STB3/esphome-hotcirc/packages/bg_disinfection_magenta.png

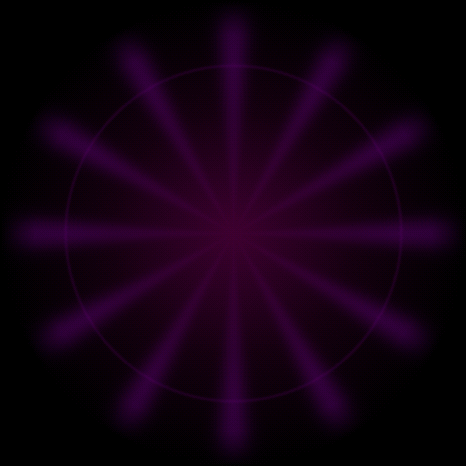
packages/bg_disinfection_magenta.png
