STB3/esphome-hotcirc/packages/bg_idle_blue.png

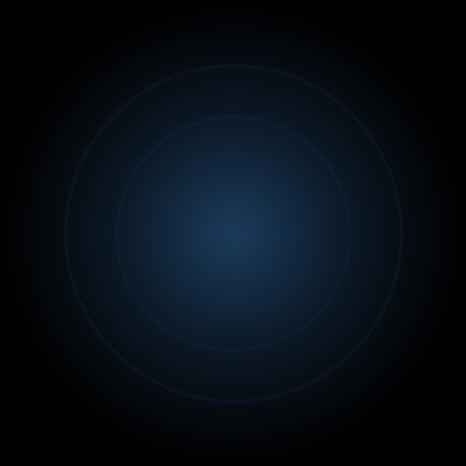
packages/bg_idle_blue.png
