STB3/esphome-hotcirc/mechanics/ring_cover.STL

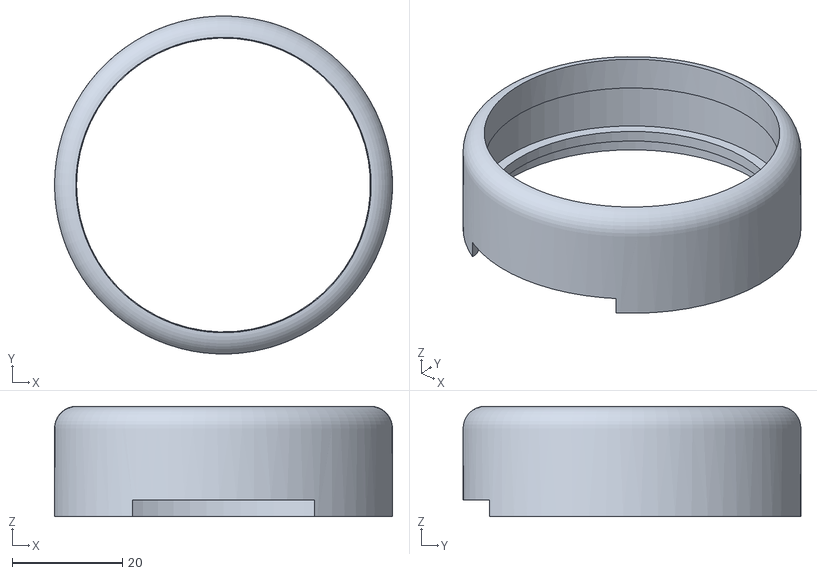
[picture p23: CAD file, 2026-10-16]
mechanics/ring_cover.STL
61.2 x 61.2 x 20.0
