STB3/esphome-hotcirc/mechanics/base.STL

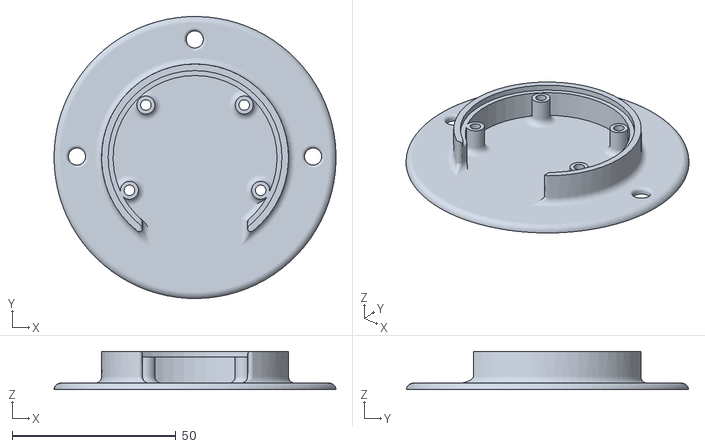
[picture p24: CAD file, 2026-10-16]
mechanics/base.STL
86.0 x 86.0 x 11.7
