STB3/esphome-hotcirc/pictures/hotcirc_red/Schematics_hotcirc_red.pdf

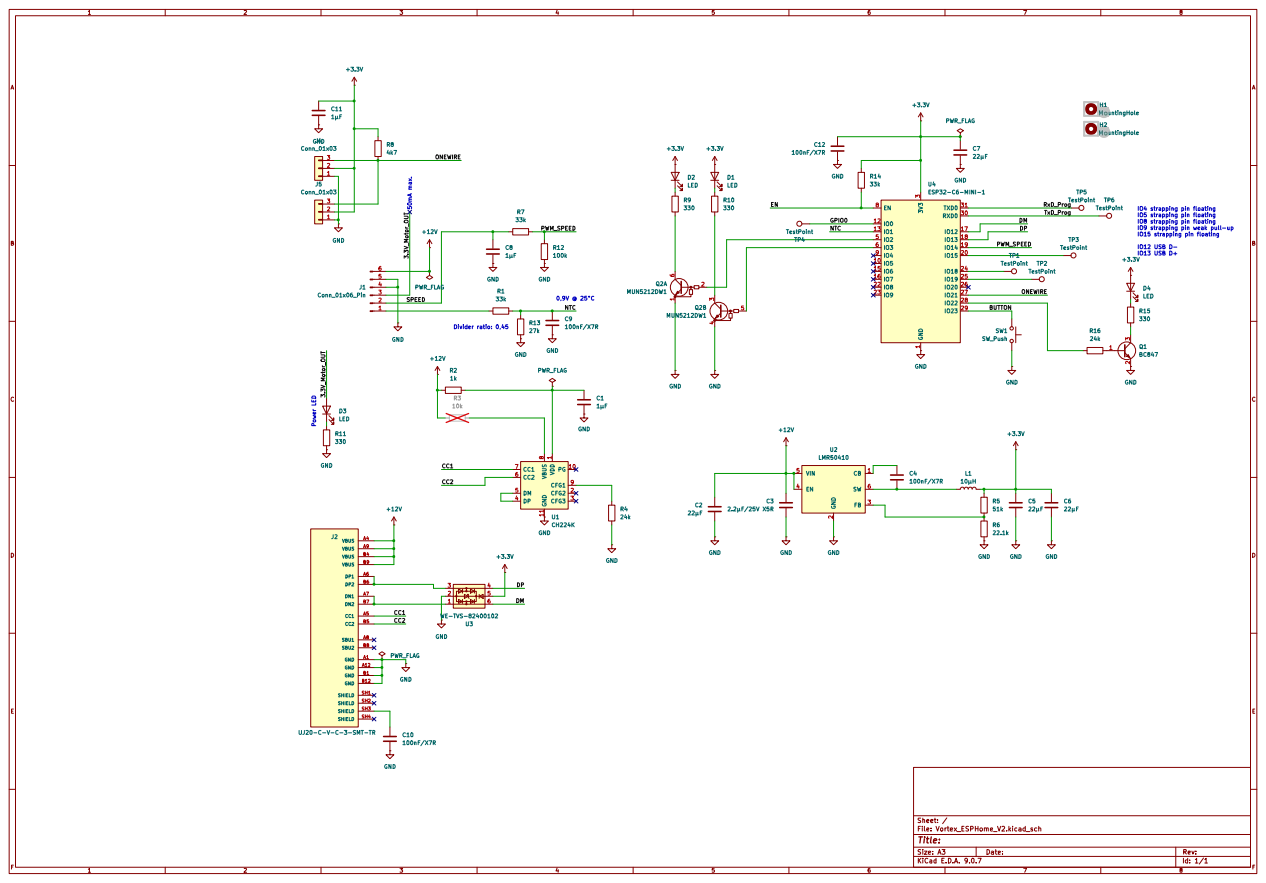
[picture p25: page 1]
