STB3/esphome-hotcirc/(commit log)

2026-02-13 Add pictures of round PCB Changed esphome-hotcirc_uedx4646.yaml to use 2 OneWire busses
2026-02-13 Add picture of schematics
2026-04-10 Fix HTML heatmap file to work with ESPHome 2026.7.0. Free ressources by not exposing internal sensors
    [esphome-hotcirc_m5stickc-plus2.yaml, esphome-hotcirc_red.yaml, esphome-hotcirc_uedx4646.yaml]
2026-04-17 feat: add thermal stagnation flush for summer heat-soak condition
    In summer, when the boiler only heats DHW, the return pipe can absorb
    heat conductively from the boiler. This causes the outlet/return delta
    to shrink or go negative, preventing the normal pump start condition
    from ever being met.
    New check_thermal_stagnation_() runs a short timed flush when:
    - (outlet - return) < thermal_stagnation_delta (default 2.0°C)
    - condition persists for 10 seconds (debounce against sensor noise)
    - return temperature >= thermal_stagnation_min_return (default 40°C)
    to exclude normal overnight cool-down convergence
    - pump is not already running
    - 30-minute cooldown since last flush has elapsed
    Chan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
    [esphome-hotcirc_m5stickc-plus2.yaml, esphome-hotcirc_red.yaml, esphome-hotcirc_uedx4646.yaml, esphome_hotcirc.cpp, esphome_hotcirc.h]
2026-05-07 Add Bill of Materials Change thermal stagnation times
2026-05-07 Add Schematics_hotcirc_red.pdf
2026-05-09 Add factory reset button and safe mode button.
2026-05-09 Add factory reset and safe modde buttons.
    [esphome-hotcirc_m5stickc-plus2.yaml, esphome-hotcirc_uedx4646.yaml]
2026-06-18 fix: use POST instead of GET for smart plug switch control
    ESPHome web_server v3 requires POST requests to actuate switches.
    The previous GET requests to /switch/relay/turn_on|turn_off were
    silently ignored, preventing the pump relay from switching.
    [esphome-hotcirc_m5stickc-plus2.yaml, esphome-hotcirc_uedx4646.yaml]
2026-06-19 Add pictures for pump animation Divide yaml files into GUI and base. GUI is in packages/esphome-hotcirc_gui.yaml
2026-06-19 fix(gui): remove visible divider line between touch zones on main screen
    The separator between the upper (page switch) and lower (smart plug test)
    touch zones was rendered as a visible grey line. Two causes were addressed:
    1. Removed the explicit `sep_line` line widget and its associated
    substitution variables (`sep_y`, `sep_half_width`).
    2. Suppressed the LVGL default theme styling on both transparent touch
    buttons (`touch_top`, `touch_btm`) by explicitly setting
    `border_opa: TRANSP`, `outline_width: 0`, `outline_opa: TRANSP`,
    `shadow_width: 0`, and `radius: 0`.
    [esphome-hotcirc_gui.yaml]
2026-06-19 Moved temperatures a bit ,ore to the middle of the display.
2026-06-20 fix(hotcirc): water-draw detection on display node + boot lockout bug
    Water-draw detection never triggered on the UEDX4646 variant while the
    red variant worked. Root cause was twofold:
    1. Anti-stagnation boot lockout (the actual blocker)
    check_anti_stagnation_() initialized last_anti_stagnation_run_ to the
    current time on first valid clock tick. The 30-minute post-run lockout
    (now - last_anti_stagnation_run_ < 1800) then treated this reference
    point as a real run, suppressing water-draw detection AND scheduled
    runs for 30 min after every boot. Frequent reflashing on the display
    node kept testing inside that window. Backdate the init reference by
    1h so the lockout is ina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
    [esphome-hotcirc_gui.yaml, esphome-hotcirc_uedx4646.yaml, esphome_hotcirc.cpp, esphome_hotcirc.h]
2026-06-20 feat: highlight outlet temp label yellow on potential water draw
    Add `draw_pending_` flag (bool, default false) to HotWaterController.
    Set to true in `on_outlet_sample_()` when a potential water draw is first
    detected (draw_detection_started_ == 0). Cleared in
    `reset_water_draw_detection_()`, which covers all exit paths: confirmed
    draw, detection abort, and pump start.
    In the GUI update interval (500 ms lambda), apply yellow (0xFFD700) to
    `lbl_outlet_temp` while `draw_pending_` is true, white (0xFFFFFF)
    otherwise.
    [esphome-hotcirc_gui.yaml, esphome_hotcirc.cpp, esphome_hotcirc.h]
2026-06-21 feat(display): add 3-stage AMOLED burn-in protection with auto-dimming
    Introduces a new package `esphome-hotcirc_dimming.yaml` and corresponding
    changes to the GUI and hardware variant files to protect the CO5300 AMOLED
    panel from burn-in by reducing average luminance during inactivity.
    Dimming stages (timeouts configurable via substitutions):
    - Stage 0 ACTIVE: full brightness (controlled by 'Display Brightness' number)
    - Stage 1 DIM: reduced to 25% after 30 s of inactivity; live temperatures
    continue to update (no LVGL pause)
    - Stage 2 DARK: brightness ~0 after 5 min of inactivity (screensaver)
    Wake-up behaviour:
    - First touch wakes the display immediately via t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
    [esphome-hotcirc_gui.yaml, esphome-hotcirc_uedx4646.yaml]
2026-06-23 feat(uedx4646): add state-dependent radial glow backgrounds
    Add subtle radial-glow backgrounds to page_main that change with the
    pump state, giving each mode its own atmosphere without hurting contrast:
    - Idle / Learning / Water draw / Standby -> blue glow
    - Running / Forced -> warm orange glow
    - Disinfection -> magenta glow + rays
    - Disabled -> none (pure black)
    Backgrounds are three 466x466 RGB565 PNGs, dithered to avoid banding,
    placed as the bottom Z-layer in page_main and toggled via show/hide in
    update_gui (same pattern as the pump icons). Pure black at the edges
    keeps the AMOLED pixels off. No runt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
    [esphome-hotcirc_gui.yaml]
2026-06-23 feat(uedx4646): add interactive browser simulator + two-tone HotCirc logo
    Simulator (docs/hotcirc_simulator.html)
    - Self-contained single HTML file (~55 KB, no dependencies except Google
    Fonts CDN), served via GitHub Pages at docs/
    - Round 466x466 AMOLED display rendered as live SVG with correct arc
    geometry (120° start, 300° sweep, ECO-level dot indicator)
    - All 7 operating states selectable: Standby, Running, Learning,
    Disinfection, Disabled, Forced, Water draw
    - State-dependent radial glow backgrounds (blue / orange / magenta / none)
    matching the real LVGL backgrounds
    - Real pump icon PNGs (pump_icon.png + f0/f1/f2) embedded as base64
    alpha masks, recolored per state via SVG f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
    [esphome-hotcirc_gui.yaml]
2026-06-24 fix(simulator): align all states with real pump_status strings
    The previous simulator used invented state labels that didn't match the
    actual pump_status text sensor output. Corrected to reflect the exact
    strings produced by the PumpTrigger switch in esphome-hotcirc_uedx4646.yaml.
    Removed:
    - "Running" → was never a standalone status string
    - "Learning" → not a pump_status state; learning runs silently
    in the background while pump_status shows "Standby"
    - "Forced" → not a real trigger name
    - "Water draw" → was shown as Idle/blue; pump actually runs (orange)
    Added (all prefixed "Running: …" as the firmware produces them):
    - Runn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
2026-07-07 Add relay state verification to smart plug connectivity check
    Query GET /switch/relay instead of /sensor/status so a single request
    checks both reachability and the actual relay state. Parse the JSON
    response body ("value":true/false) and compare it against the expected
    pump_relay state. On mismatch (e.g. plug rebooted or a switch command
    was lost), log a warning and re-send the last commanded state - the
    controller remains master.
    - check_smart_plug_script: verify HTTP status 200, mark plug
    online/offline, reconcile relay state every 60 s
    - test_smart_plug_script: use the same endpoint and log actual vs.
    expected relay state for manual diagnostics
    - Requires ESPHome 2024.6+ (capture_re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
    [esphome-hotcirc_uedx4646.yaml]
2026-07-07 Apply relay state verification to M5StickC Plus2 variant
    Port smart plug connectivity check changes from UEDX4646:
    query /switch/relay, verify actual relay state and re-send
    the last commanded state on mismatch.
2026-07-08 fix(hotcirc): resolve state, timing and persistence bugs; unify config and logging
    Firmware (esphome_hotcirc.cpp/.h):
    - Guard clock_ access in handle_user_request()/learn_now(); both run in the
    outlet sensor callback path, which fires before SNTP sync (crash/wrong-slot
    learning risk). Water draw still starts the pump when the clock is invalid.
    - Replace blocking LED flash after matrix reset (6x delay(200) = 1.2 s loop
    stall) with a non-blocking sequence driven from update_leds().
    - Remove file-local millis()/delay() wrappers; use esphome/core/hal.h.
    - Remove deprecated poll-based detect_water_draw() (superseded by
    on_outlet_sample_()) and the never-defined propagate_first_day_().
    - D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
    [esphome-hotcirc_uedx4646.yaml, esphome_hotcirc.cpp, esphome_hotcirc.h]
2026-07-08 chore(hotcirc-red): align red variant config with new component API
    Update esphome-hotcirc_red.yaml for the reworked .cpp/.h. All config
    keys and lambda symbols stay backward-compatible, so no functional
    rewrite is needed; this only removes dead config and syncs values/tags.
    - Remove unused anti_stagnation_interval (FIX #6): anti-stagnation now
    runs on a fixed weekly schedule (Sun 03:00), the interval is ignored
    - Fix thermal_stagnation_delta 3.0 -> 2.0 to match comment and uedx4646
    - Add logger logs block with hotcirc/learning tags (FIX #20 tag rename)
    - Document water-draw callback binding (FIX #10) and one-time learning
    matrix reset on first boot (FIX #11) in an inline migration note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
    [esphome-hotcirc_red.yaml]
2026-07-08 fix(smart_plug): debounce offline detection and add fast reconcile on failed switch commands
    The BK7231N smart plug intermittently refuses a single TCP connect
    (esp-tls select() timeout / ESP_ERR_HTTP_CONNECT) but recovers on the
    next 60s check. Previously a single failed GET immediately flagged the
    plug OFFLINE, spamming the log with transient WARN entries, and a lost
    turn_on/turn_off POST was only corrected up to 60s later by periodic
    reconciliation.
    - Add plug_fail_count global; require 2 consecutive failures before
    reporting OFFLINE. Reset counter on any HTTP 200. Transient errors now
    log at DEBUG instead of WARN.
    - On failed turn_on/turn_off POST, trigger check_smart_plug_script af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
    [esphome-hotcirc_uedx4646.yaml]
2026-10-16 Add stl wall mount files
2026-10-16 fix(heatmap): auto-refresh toggle ignored clicks on the switch
    The checkbox sat inside a <label> within the button, so clicking the
    switch toggled it natively before the button's onclick ran. The handler
    then read the already-flipped state and immediately reverted it, so only
    clicks on the "Auto-refresh" text worked.
    - Replace the <label> wrapper with a <span> to stop native toggling
    - Track auto-refresh state via the interval handle instead of the
    checkbox; the checkbox now only reflects that state
    - Make the hidden checkbox non-interactive (pointer-events: none,
    tabindex="-1")
2026-10-27 Fix button/vacation logic, align Red and M5StickC with UEDX, update docs
    Firmware (esphome_hotcirc.cpp)
    - FIX #23: Vacation timer reset and vacation exit now happen on every
    confirmed water draw, not only inside learn_now(). With learning
    disabled, the system previously entered vacation mode after 24 h
    despite daily use and never left it again. Without a valid clock the
    timer is cleared so it re-initializes on the next valid timestamp.
    All variants
    - FIX #24: "Run Circulation Pump" web UI button now calls
    manual_pump_on() (trigger MANUAL_WEBUI). Pump Status showed
    "Manual Button" instead of "Web UI" before.
    UEDX4646 and M5StickC Plus2
    - FIX #22: Hardware button is evaluated by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
2026-10-30 docs: use entity-name URL for Learning Matrix JSON endpoint
    ESPHome's web server deprecates object-ID URLs such as
    /text_sensor/learning_matrix_json and removes them in 2026.7.0.
    Update the documentation to the entity-name form
    /text_sensor/Learning%20Matrix%20JSON.
    - homeassistant/hotcirc_HA_readme{,_en}.md: use the new URL in the
    endpoint check and the REST package example, explain how the path
    is derived from the sensor name, add a note on the deprecated
    format and a troubleshooting entry for the "Deprecated URL format"
    log warning
    - README.md: correct the endpoint described for the standalone
    heatmap page
    - homeassistant/hotcirc.yaml: replace the hardcoded IP with a
    <HOTCIRC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
2026-10-30 docs: clarify smart plug relay switch is addressed by name
    The ESPHome web server addresses entities by their name, not by
    their id:. The smart plug requests (/switch/relay/...) therefore
    require the plug's relay switch to be named "relay".
    - README.md: state in "Smart Plug Control" and in installation
    step 4 that the relay switch must have the name "relay" instead
    of the ID "relay"
2026-11-04 Add PCB manufacturing files (Gerber, drill, BOM) and readme
2026-11-04 Created PCB manufacturing folder for the uedx4646 display and moved the fabrication data to it
